PV-Lab/hte_degradation_chamber/MIT Gen1 Chamber BOM.xlsx

Material | Chamber Use Description | Cost | Link | ALL PRICES BASED ON US$ IN 2022
2 pcs of 66 quart / 62 L Sterilite ClearView plastic home storage boxes | Outer chamber | $20.00 | https://www.walmart.com/ip/Sterilite-66-Qt-Latch-Box-Plastic-Stadium-Blue-Set-of-6/711933680
Aluminum Extrusions 40mm |  | $200.00 | Estimated.
M5 x8 Screws and Nuts |  | $50.00 | Estimated.
DL0097 Advanced Illumination Lamp with ICS IC Inline Controller |  | $500.00 | Internal quote
ThorLabs DCC1645C, Obsolete: replaced by ThorLabs CS165CU | Camera imager | $448.05 | https://www.thorlabs.com/thorproduct.cfm?partnumber=CS165CU
ThorLabs MVL6WA | Camera lens | $166.38 | https://www.thorlabs.com/thorproduct.cfm?partnumber=MVL6WA
Xrite ColorChecker Passport, Discontinued; replaced by SCK200 SpyderCHCKR 24 | Camera color calibration | $49.00 | https://www.amazon.com/dp/B00LPS46TW?s=photo&sp_csd=d2lkZ2V0TmFtZT1zcF9kZXRhaWxfdGhlbWF0aWM
Heat Shrink |  | $13.99 | https://www.amazon.com/Wirefy-180-Heat-Shrink-Tubing/dp/B084GDLSCK?s=industrial
Electrical connector variety kit |  | $9.99 | https://www.amazon.com/dp/B09YTV31W4?s=industrial&sp_csd=d2lkZ2V0TmFtZT1zcF9kZXRhaWw
Breadboard and jumper wires |  | $10.99 | https://www.amazon.com/Standard-Jumper-Solderless-Prototype-Breadboard/dp/B07H7V1X7Y?s=industrial
SOLO AutomationDirect temperature controller | Water temperature feedback controller | $45.00 | https://www.automationdirect.com/adc/shopping/catalog/process_control_-a-_measurement/temperature_-z-_process_controllers/basic_temperature_controllers/slb484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
Type K thermocouple | Water temperature measurement | $38.96 | https://www.digikey.com/en/products/detail/klein-tools-inc/69142/8543402
3 pcs of desktop computer fans | Water vapor transport | $30.87 | https://www.digikey.com/en/products/detail/cui-devices/CFM-4010-13-10/6194919
Power supply 24V | Power supply | $20.63 | https://www.digikey.com/en/products/detail/hammond-manufacturing/BPD2G/454375
Arduino Uno Rev3 | Microcontroller | $26.35 | https://www.amazon.com/Arduino-A000066-ARDUINO-UNO-R3/dp/B008GRTSV6?cv_ct_cx=arduino+uno+rev3
Adafruit Si7021 | Temperature and humidity sensor | $9.95 | https://www.digikey.com/en/products/detail/adafruit-industries-llc/3251/6227008
Graphite block 6"x6", 1" Thick | Sample holder | $94.37 | https://www.mcmaster.com/9121K66/
 | TOTAL | $1734.53
