PV-Lab/hte_degradation_chamber/(commit log)

2022-06-21 Tree figure describing chamber generations
2022-08-18 Add files via upload
    More detailed cost estimates
    [MIT Gen1 Chamber BOM.xlsx]
